strupppi/mcprog/mcprog.brd

## EAGLE design mcprog.brd (2014-10-20)

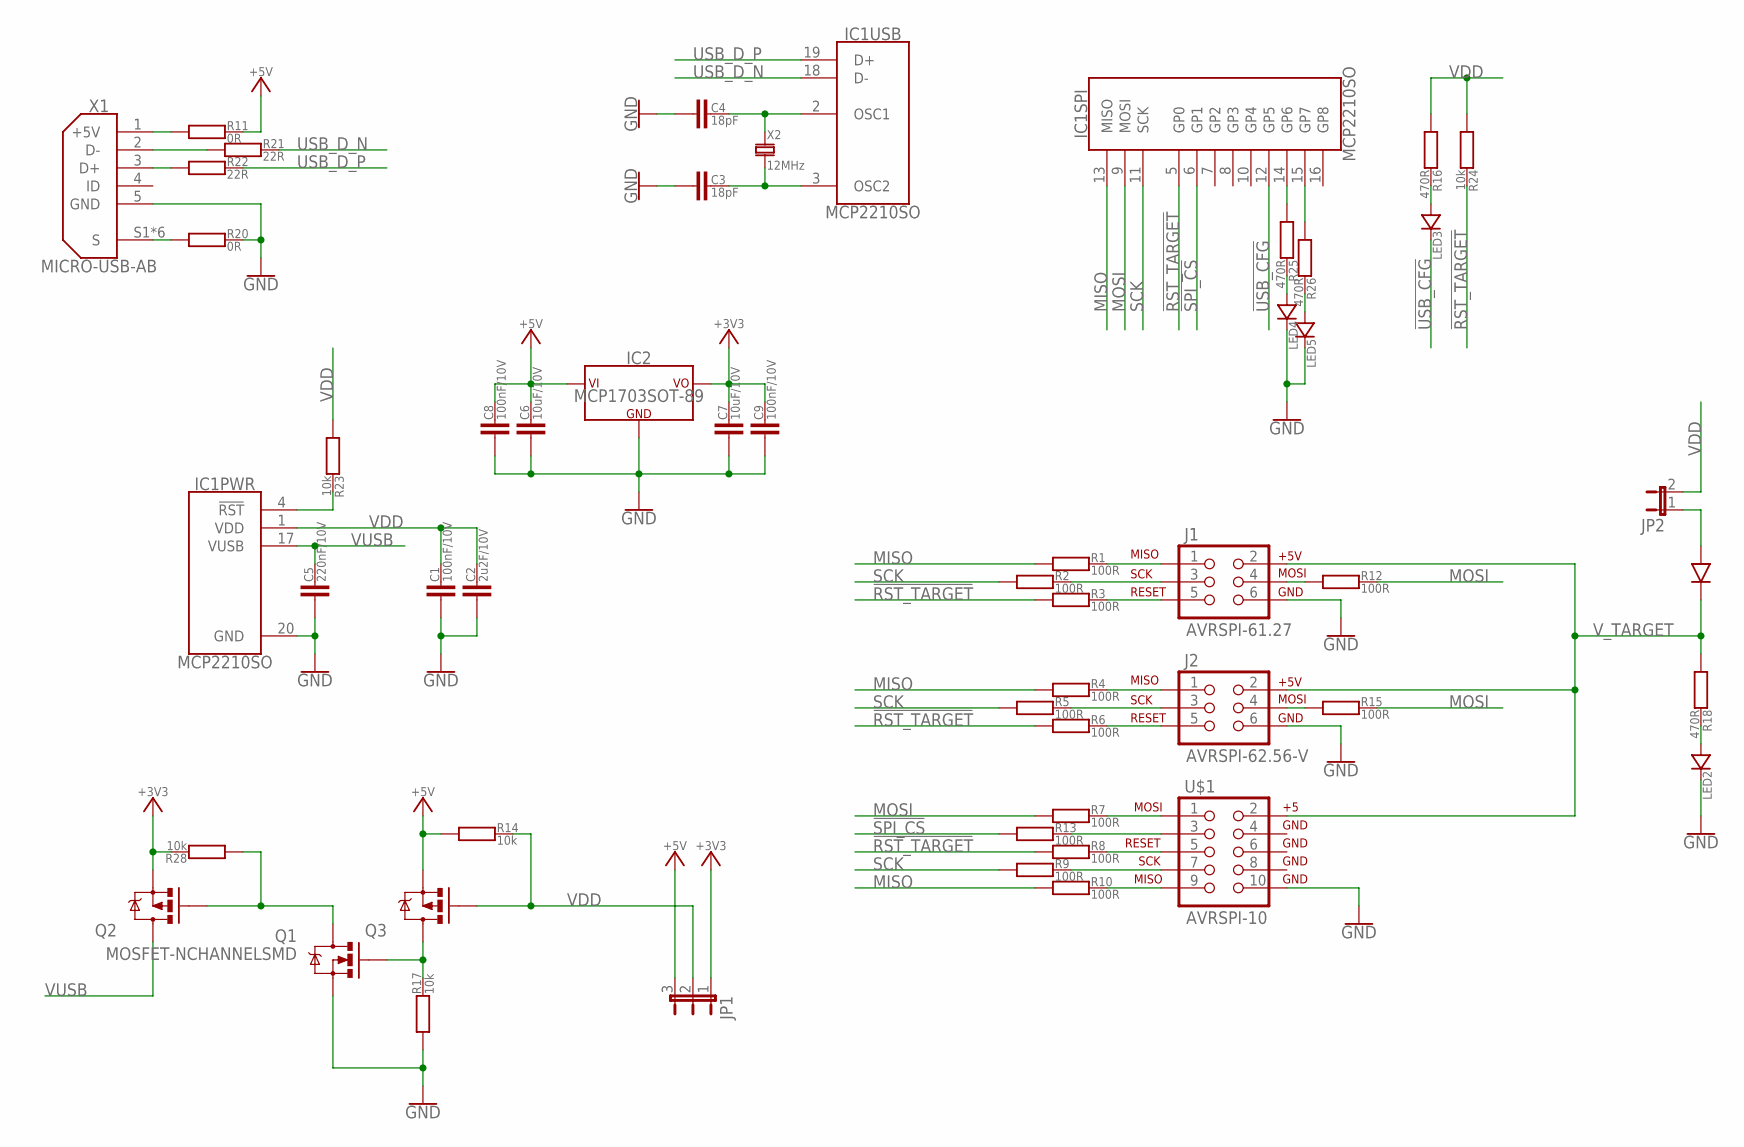
[picture p1: schematic mcprog.sch]

Parts:
C1, C8, C9: 100nF/10V; C0603
C2: 2u2F/10V; C1206
C3, C4: 18pF; C0603
C5: 220nF/10V; C0603
C6, C7: 10uF/10V; C1206
D1: 1N5819HW; SOD123
IC1: MCP2210SO; SOIC20-W
IC2: MCP1703SOT-89; SOT89
J1: AVRSPI-61.27; 2X3-1.27
J2: AVRSPI-62.56-V; 2X3-NS
JP1: JP2E; JP2
JP2: JP1E; JP1
LED2, LED3, LED4, LED5: LED0603
Q1: MOSFET-NCHANNELSMD; SOT23-3
Q2, Q3: MOSFET-PCHANNEL; SOT23
R1, R2, R3, R4, R5, R6, R7, R8, R9, R10, R12, R13, R15: 100R; R0603
R11, R20: 0R; R0603
R14, R17, R23, R24, R28: 10k; R0603
R16, R18, R25, R26: 470R; R0603
R21, R22: 22R; R0603
U$1: AVRSPI-10; AVR_ICSP
X1: MICRO-USB-AB; ZX62-B-5PA(11)
X2: 12MHz; HC49UP

Connections:
!RST_TARGET!: IC1.5 (GP0), R3.1, R6.1, R8.1, R24.2
!SPI_CS!: IC1.6 (GP1), R13.1
!USB_CFG!: IC1.12 (GP5), LED3.C
+3V3: C7.2, C9.2, IC2.3 (VCC), JP1.1, Q2.2 (S), R28.2
+5V: C6.2, C8.2, IC2.2 (VIN), IC2.4 (VIN), JP1.3, Q3.2 (S), R11.2, R14.1
GND: C1.1, C2.1, C3.1, C4.1, C5.1, C6.1, C7.1, C8.1, C9.1, IC1.20 (GND), IC2.1 (GND), J1.6 (GND), J2.6 (GND), LED2.C, LED4.C, LED5.C, Q1.2 (S), R17.1, R20.2, U$1.10, X1.5 (GND)
MISO: IC1.13 (MISO), R1.1, R4.1, R10.1
MOSI: IC1.9 (MOSI), R7.1, R12.2, R15.2
unnamed: J1.1 (MISO), R1.2
unnamed: J1.3 (SCK), R2.2
unnamed: J1.5 (RESET), R3.2
unnamed: J2.1 (MISO), R4.2
unnamed: J2.3 (SCK), R5.2
unnamed: J2.5 (RESET), R6.2
unnamed: R7.2, U$1.1
unnamed: R8.2, U$1.5
unnamed: R9.2, U$1.7
unnamed: R10.2, U$1.9
unnamed: Q1.1 (G), Q3.3 (D), R17.2
unnamed: LED3.A, R16.2
unnamed: Q1.3 (D), Q2.1 (G), R28.1
unnamed: J2.4 (MOSI), R15.1
unnamed: LED2.A, R18.2
unnamed: IC1.14 (GP6), R25.1
unnamed: J1.4 (MOSI), R12.1
unnamed: R13.2, U$1.3
unnamed: C4.2, IC1.2 (OSC1), X2.1
unnamed: C3.2, IC1.3 (OSC2), X2.2
unnamed: R21.1, X1.2 (D-)
unnamed: R22.1, X1.3 (D+)
unnamed: R11.1, X1.1 (+5V)
unnamed: R20.1, X1.S1 (S), X1.S2 (S), X1.S3 (S), X1.S4 (S), X1.S5 (S), X1.S6 (S)
unnamed: LED4.A, R25.2
unnamed: D1.A, JP2.1
unnamed: IC1.4 (!RST!), R23.2
unnamed: LED5.A, R26.2
unnamed: IC1.15 (GP7), R26.1
SCK: IC1.11 (SCK), R2.1, R5.1, R9.1
USB_D_N: IC1.18 (D-), R21.2
USB_D_P: IC1.19 (D+), R22.2
VDD: C1.2, C2.2, IC1.1 (VDD), JP1.2, JP2.2, Q3.1 (G), R14.2, R16.1, R23.1, R24.1
VUSB: C5.2, IC1.17 (VUSB), Q2.3 (D)
V_TARGET: D1.C, J1.2 (+5V), J2.2 (+5V), R18.1, U$1.2

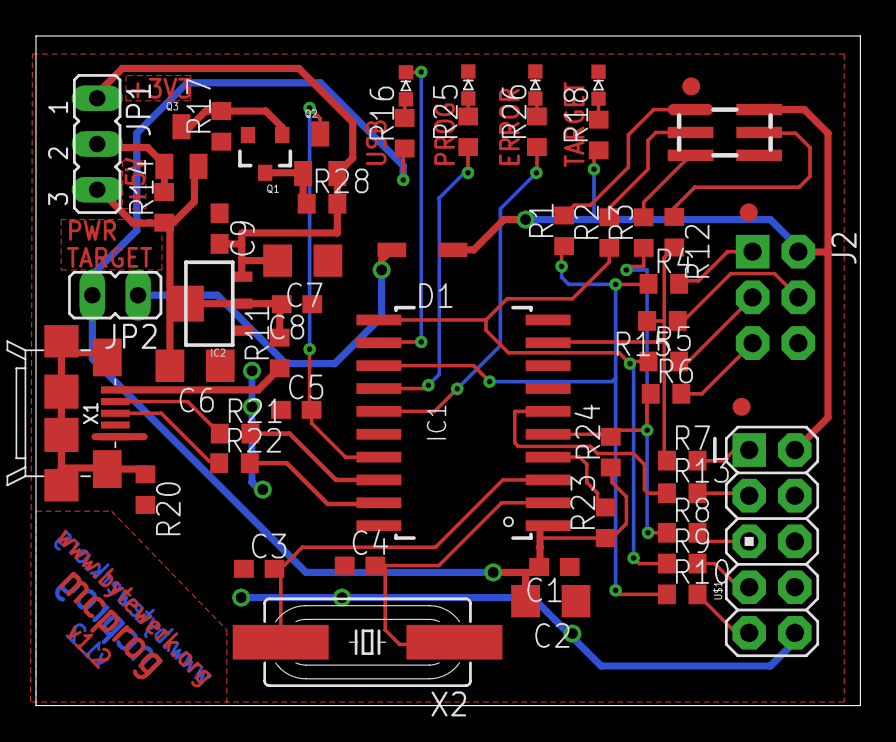
[picture p2: board mcprog.brd from above]

Board: 2 copper layers, 45.8 x 37.2 mm, 52 parts (0 on the bottom side), 43 nets.
