strupppi/mcprog/(commit log)

2014-09-13 schematics: done.
    [mcprog.brd, mcprog.sch]
2014-09-13 board, v1
    [mcprog.brd, mcprog.sch]
2014-09-14 Fixing some minor DRC problems. R23 now is 10k
    [mcprog.brd, mcprog.sch]
2014-09-14 improve GND path
    [mcprog.brd, mcprog.sch]
2014-09-14 put flipped text on backside
    [mcprog.brd]
2014-10-12 attach PROG led to GPIO6 instead of GPIO8 GPIO8 refused to be an output for some unknown reason
    [mcprog.brd, mcprog.sch]
2014-10-20 v1.2 with various small changes
    [mcprog.brd, mcprog.sch]
