strupppi/mcprog/(notices)

Notices in the files:
parts and their libraries:
bytewerk-frames: Creative Commons 3.0 CC-BY-SA
bytewerk-crystal: CC-BY-SA
mcp2210: Creative Commons v3.0 CC-BY-SA
